hippoBus/pyoro-mms/img/pyoro.png

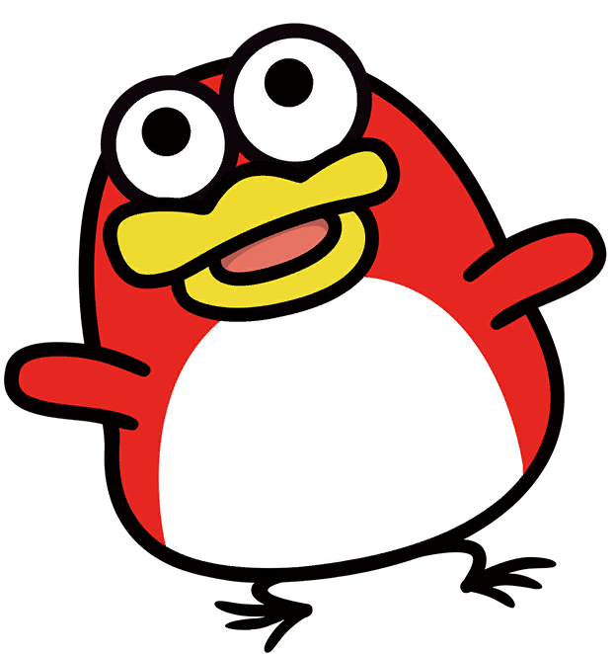
img/pyoro.png
