hippoBus/pyoro-mms/BOM.xlsx

Supplier | Order | Part Number | Count | Quantity | Unit Price | Total Cost | Status | Notes | Link | Datasheet
Digikey | IR. Emitter (940nm) | SFH 4545 | 4 | 10 | 0.529 | 2.116 | Not Ordered |  | https://www.digikey.com/short/p79947wh | https://look.ams-osram.com/m/3456970c8eccd2cb/original/SFH-4545.pdf
 | IR Reciever | TEFT4300 | 4 | 10 | 0.467 | 1.868 | Not Ordered |  | https://www.digikey.com/short/tznrt051 | https://www.vishay.com/docs/81549/teft4300.pdf
 | NMOS | PJA3428_R1_00001 | 5 | 1 | 0.467 | 2.335 | Not Ordered |  | https://www.digikey.com/short/jj7zfb9v | https://toshiba.semicon-storage.com/info/SSM3K335R_datasheet_en_20250321.pdf?did=13020&prodName=SSM3K335R
 | 6-pin JST Header | BM06B-SRSS-TB | 5 | 1 | $0.67 | 3.35 | Not Ordered |  | https://www.digikey.com/short/7rzcn2wm | https://www.jst-mfg.com/product/pdf/eng/eSH.pdf
 | STM32H5 (48 pin) | STM32H503CBT7 | 3 | 1 | 3.54 | 10.62 | Not Ordered | 19 stock remaining | https://www.digikey.com/short/ddcf4p0p | https://www.st.com/resource/en/datasheet/stm32h503eb.pdf
 | Neopixel (10 pack) | 1655 | 1 | 1 | 4.5 | 4.5 | Not Ordered | Package has 10 LEDs | https://www.digikey.com/short/bnrh49nr | https://mm.digikey.com/Volume0/opasdata/d220001/medias/docus/6130/1655.pdf
 | 9-Axis IMU | ICM-20948 | 2 | 1 | 6.78 | 13.56 | Not Ordered |  | https://www.digikey.com/short/0j78n5mz | https://invensense.tdk.com/wp-content/uploads/2024/03/DS-000189-ICM-20948-v1.6.pdf
 | Power Switch | SLW-105558-2A-N-D | 2 | 1 | 0.39 | 0.78 | Not Ordered |  | https://www.digikey.com/short/3vjdjwpw | https://www.sameskydevices.com/product/resource/slw-105558-2a-n-d.pdf
 | Push Button |  | 2 | 1
 | Buzzer | PT-1306T | 1 | 1 | 0.61 | 0.61 | Not Ordered |  | https://www.digikey.com/short/r792247f | https://www.soberton.com/wp-content/uploads/2022/03/PT-1306T.pdf
 | Gate Driver | UCC27524DSDR | 2 | 1 | 1.94 | 3.88 | Not Ordered |  | https://www.digikey.com/short/rztp78f9 | https://www.ti.com/general/docs/suppproductinfo.tsp?distId=10
 | MOSFET H-Bridge | ZXMHC3F381N8TC | 2 | 1 | 1.62 | 3.24 | Not Ordered |  | https://www.digikey.com/short/t558799t | https://www.diodes.com/assets/Datasheets/ZXMHC3F381N8.pdf
 | Yellow LED | B1501UY--20D001913U1930 | 10 | 10 | 0.057 | 0.57 | Not Ordered |  | https://www.digikey.com/short/t550nvpn | https://mm.digikey.com/Volume0/opasdata/d220001/medias/docus/544/B1501UY--20D001913U1930.pdf
 | 1V8 LDO Regulator | MC78LC18NTRG | 1 | 1 | 0.22 | 0.22 | Not Ordered |  | https://www.digikey.com/short/3zfbp3h8 | https://www.onsemi.com/pdf/datasheet/mc78lc00-d.pdf
 | 3V3 LDO Regulator | AP2210N-3.3TRG1 | 1 | 1 | 0.2 | 0.2 | Not Ordered |  | https://www.digikey.com/short/5wrhmztf | https://www.diodes.com/assets/Datasheets/AP2210.pdf
 | 5V LDO Regulator | LM1085ISX-5.0/NOPB | 1 | 1 | 1.84 | 1.84 | Not Ordered |  | https://www.digikey.com/short/f0f7whp5 | https://www.ti.com/lit/ds/symlink/lm1085.pdf
 | 0.1uF Ceramic Cap | C1206C104K5RAC7210 | 13 | 10 | 0.061 | 0.793 | Not Ordered |  | https://www.digikey.com/short/bq453dtn | https://www.yageogroup.com/content/datasheet/asset/file/KEM_C1002_X7R_SMD
 | 1uF Ceramic Cap | CL31B105KAHNNNE | 7 | 1 | 0.12 | 0.84 | Not Ordered |  | https://www.digikey.com/short/7zt9p85r | https://weblib.samsungsem.com/mlcc/mlcc-ec-data-sheet.do?partNumber=CL05Y105KP6VPN
 | 2.2uF Ceramic Cap | CL10A225KO8NNNC | 3 | 1 | 0.08 | 0.24 | Not Ordered |  | https://www.digikey.com/short/f93t7b49 | https://mm.digikey.com/Volume0/opasdata/d220001/medias/docus/421/CL10A225KO8NNNC_Spec.pdf
 | 10uF Tantalum Cap | TAJA106K010SNJ | 2 | 1 | 0.33 | 0.66 | Not Ordered |  | https://www.digikey.com/short/rmr598h3 | https://datasheets.kyocera-avx.com/TAJ.pdf
 | 4.7uF Ceramic Cap | GRM188R61E475KE11D | 3 | 1 | 0.08 | 0.24 | Not Ordered |  | https://www.digikey.com/short/bqb93zpw | https://search.murata.co.jp/Ceramy/image/img/A01X/G101/ENG/GRM188R61E475KE11-01.pdf
 | 100uF Ceramic Cap | 25YXJ100MT15X11 | 4 | 1 | 0.23 | 0.92 | Not Ordered |  | https://www.digikey.com/short/m4nh0t4v | https://www.rubycon.co.jp/wp-content/uploads/catalog-aluminum/YXJ.pdf
 | 33Ω Resistor | ERJ-6GEYJ330V | 1 | 1 | 0.1 | 0.1 | Not Ordered |  | https://www.digikey.com/short/cvdz3p45 | https://industrial.panasonic.com/cdbs/www-data/pdf/RDA0000/AOA0000C301.pdf
 | 220Ω Resistor | RC0402FR-07220RL | 18 | 10 | 0.007 | 0.126 | Not Ordered |  | https://www.digikey.com/short/52hjjmzj | https://www.yageo.com/upload/media/product/products/datasheet/rchip/PYu-RC_Group_51_RoHS_L_12.pdf
 | 500Ω Resistor | RT0603BRC07500RL | 1 | 1 | 0.45 | 0.45 | Not Ordered |  | https://www.digikey.com/short/vdddtf3m | https://www.yageogroup.com/content/datasheet/asset/file/PYU-RT_1-TO-0-01_ROHS_L
 | 1kΩ Resistor | RC0603FR-071KL | 6 | 1 | 0.1 | 0.6 | Not Ordered |  | https://www.digikey.com/short/tjnqbzwq | https://www.yageogroup.com/content/datasheet/asset/file/PYU-RC_GROUP_51_ROHS_L
 | 10kΩ Resistor | RMCF1206FT10K0 | 1 | 1 | 0.1 | 0.1 | Not Ordered |  | https://www.digikey.com/short/d0r20hpq | https://www.seielect.com/catalog/SEI-RMCF_RMCP.pdf
 | 1mH Inductor | LB2518T102K | 1 | 1 | 0.1 | 0.1 | Not Ordered |  | https://www.digikey.com/short/5h5nmp1c | https://mm.digikey.com/Volume0/opasdata/d220001/medias/docus/610/LB2518T102K_SS.pdf
 | Shipping |  |  |  |  | 100
Pololu | Motor Encoder | 4761 | 0 | 1 | 8.95 | 0 | Arrived |  | https://www.pololu.com/product/4761 | https://www.ti.com/lit/ds/symlink/drv5013.pdf | https://www.pololu.com/file/0J1718/pololu-4760-4761-schematic.pdf | https://www.pololu.com/file/0J1721/pololu-4760-4761-dimensions.pdf
 | 50:1 HP 6V Motor | 2213 | 0 | 1 | 24.95 | 0 | Arrived |  | https://www.pololu.com/product/2213/resources | https://www.pololu.com/file/0J1487/pololu-micro-metal-gearmotors-rev-6-1.pdf
 | Wheels | 1087 | 0 | 1 | 4.45 | 0 | Arrived |  | https://www.pololu.com/product/1087/resources | https://www.pololu.com/file/0J1708/pololu-wheel-dimensions.pdf
 | 6-Pin JST Wires | 4765 | 0 | 1 | 3.32 | 0 | Arrived |  | https://www.pololu.com/product/4765
 | Motor Bracket | 989 | 0 | 1 | 2.95 | 0 | Arrived |  | https://www.pololu.com/product/989
Amazon | Motor Driver (10 pack) | L293D | 0 |  | 8.49 | 0 | Arrived | Reused motor driver, | https://www.amazon.com/Bridgold-16-pin-Stepper-Drivers-Controllers/dp/B07NXTWJV9 | https://www.digikey.com/short/npc9rw4r (https://www.digikey.com/en/products/detail/stmicroelectronics/L293D/634700?gad_source=1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)
 | Male Header (Dupont)
 | Female Header (Dupont)
 |  |  |  |  |  | TOTAL COST
 |  |  |  |  |  | 154.858
