hippoBus/pyoro-mms/kicad/componentLib/1655/1655.step

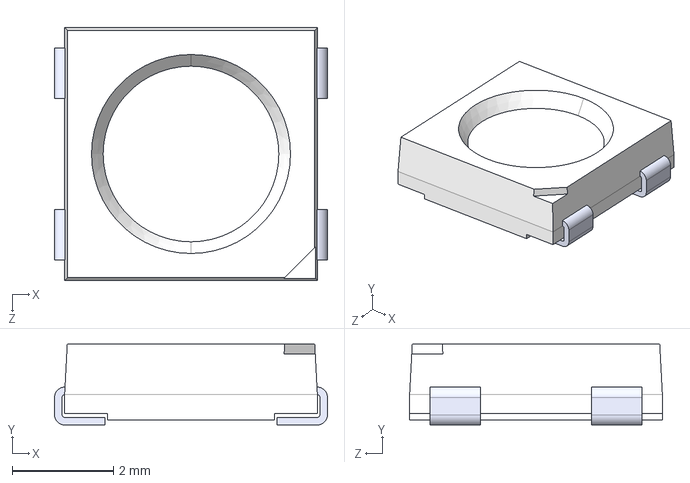
[picture p2: CAD file, 2025-07-08]
kicad/componentLib/1655/1655.step
5.40 x 1.60 x 5.00 mm
