hippoBus/pyoro-mms/kicad/componentLib/AP2210N_3_3TRG1/SOT_3_3TRG1_DIO.step

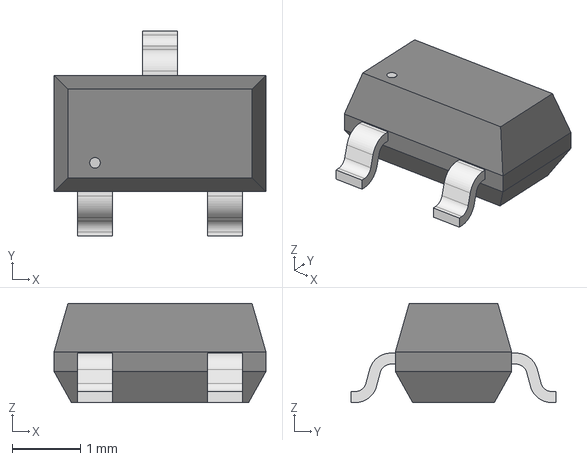
[picture p3: CAD file, 2025-08-04]
kicad/componentLib/AP2210N_3_3TRG1/SOT_3_3TRG1_DIO.step
3.10 x 3.00 x 1.45 mm
