hippoBus/pyoro-mms/kicad/componentLib/BM06B_SRSS_TB_LF__SN_/BM06B-SRSS-TB.STEP

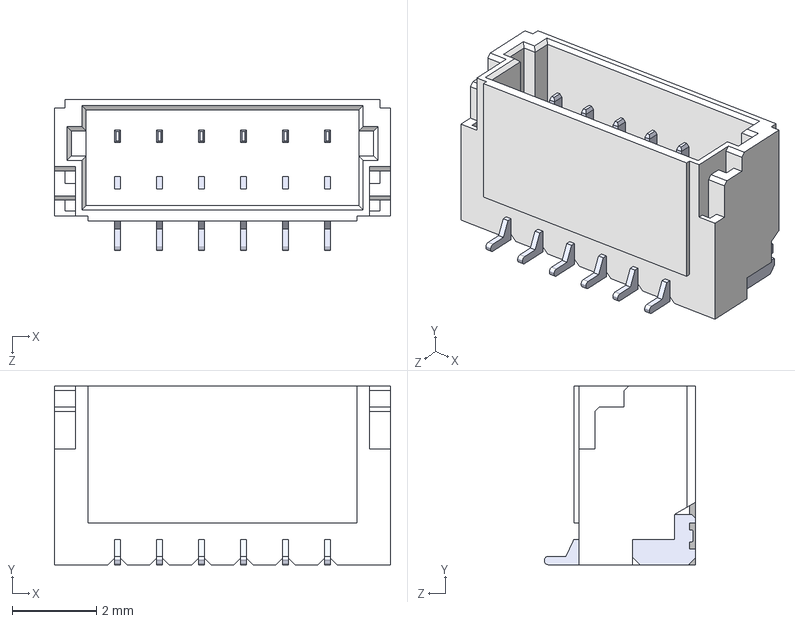
[picture p4: CAD file, 2025-07-08]
kicad/componentLib/BM06B_SRSS_TB_LF__SN_/BM06B-SRSS-TB.STEP
8.00 x 4.25 x 3.60 mm
