hippoBus/pyoro-mms/kicad/componentLib/Cutout.dxf

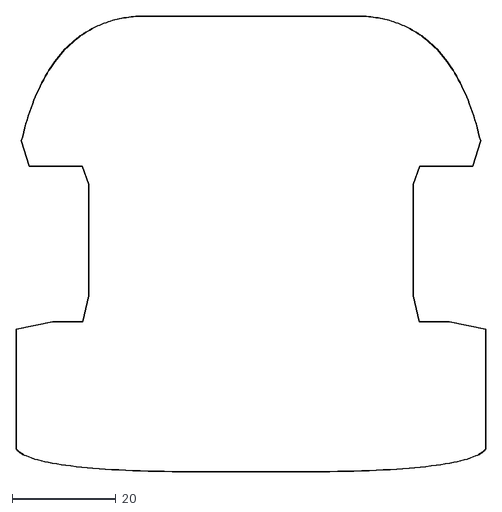
[picture p5: CAD file, 2025-12-12]
kicad/componentLib/Cutout.dxf
90.6 x 88.0
