hippoBus/pyoro-mms/kicad/componentLib/SFH_4545/SFH_4545.step

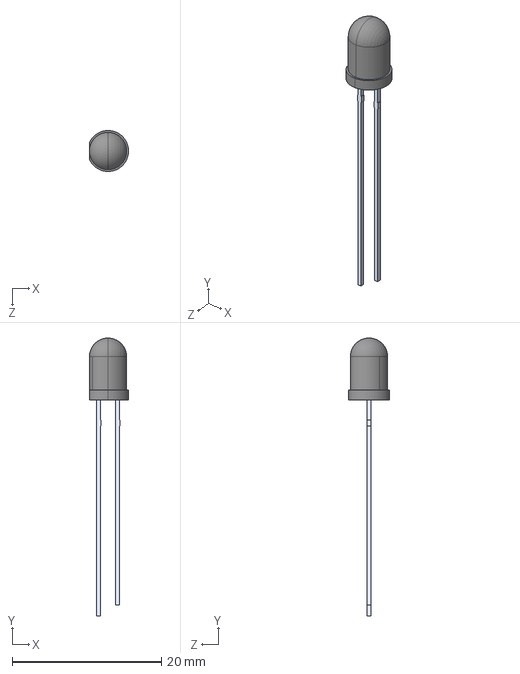
[picture p6: CAD file, 2025-07-08]
kicad/componentLib/SFH_4545/SFH_4545.step
5.25 x 37.3 x 5.50 mm
