hippoBus/pyoro-mms/kicad/componentLib/SLW_105558_2A_N_D/Same_Sky_SLW-105558-2A-N-D.step

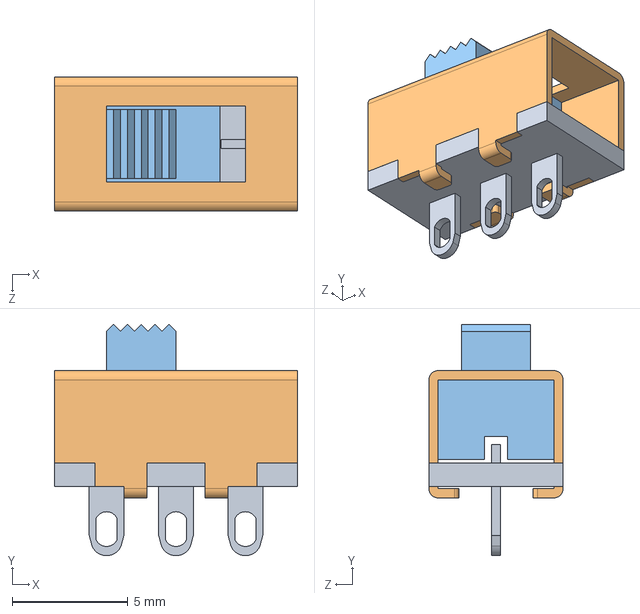
[picture p7: CAD file, 2025-07-08]
kicad/componentLib/SLW_105558_2A_N_D/Same_Sky_SLW-105558-2A-N-D.step
10.5 x 10.00 x 5.80 mm
