hippoBus/pyoro-mms/kicad/componentLib/TEFT4300/TEFT4300.step

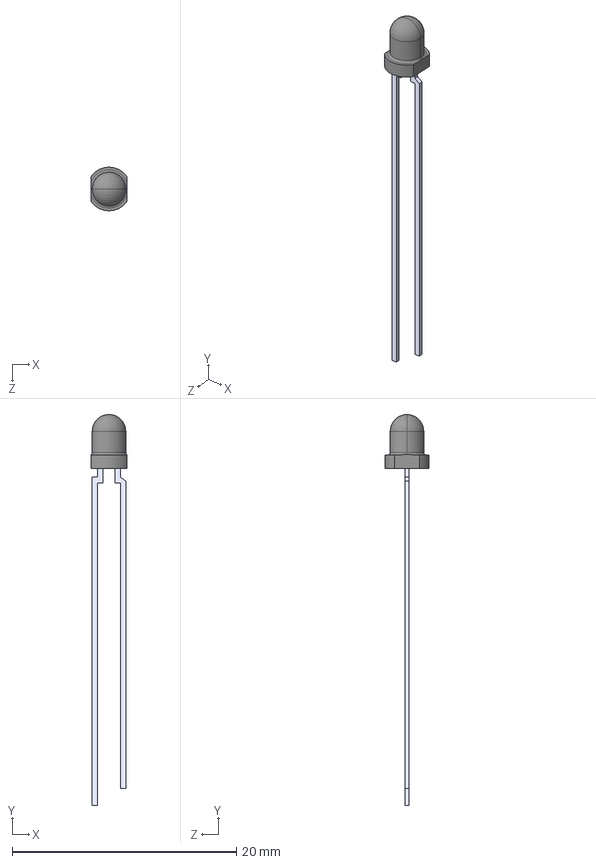
[picture p8: CAD file, 2025-07-08]
kicad/componentLib/TEFT4300/TEFT4300.step
3.20 x 34.9 x 3.90 mm
