hippoBus/pyoro-mms/kicad/componentLib/ZXMHC3F381N8TC/SOIC_81N8TC_DIO.step

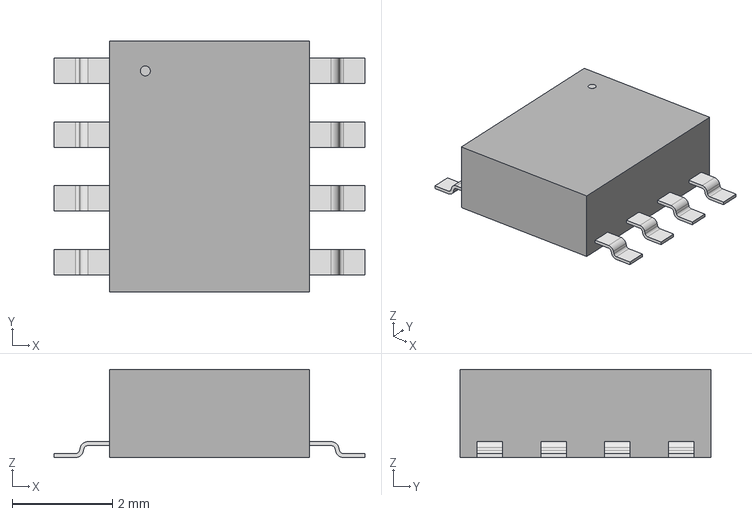
[picture p9: CAD file, 2025-11-27]
kicad/componentLib/ZXMHC3F381N8TC/SOIC_81N8TC_DIO.step
6.20 x 5.00 x 1.75 mm
