hippoBus/pyoro-mms/kicad/PYORO.kicad_pcb

## KiCad design kicad/PYORO.kicad_pcb (2025-12-18)

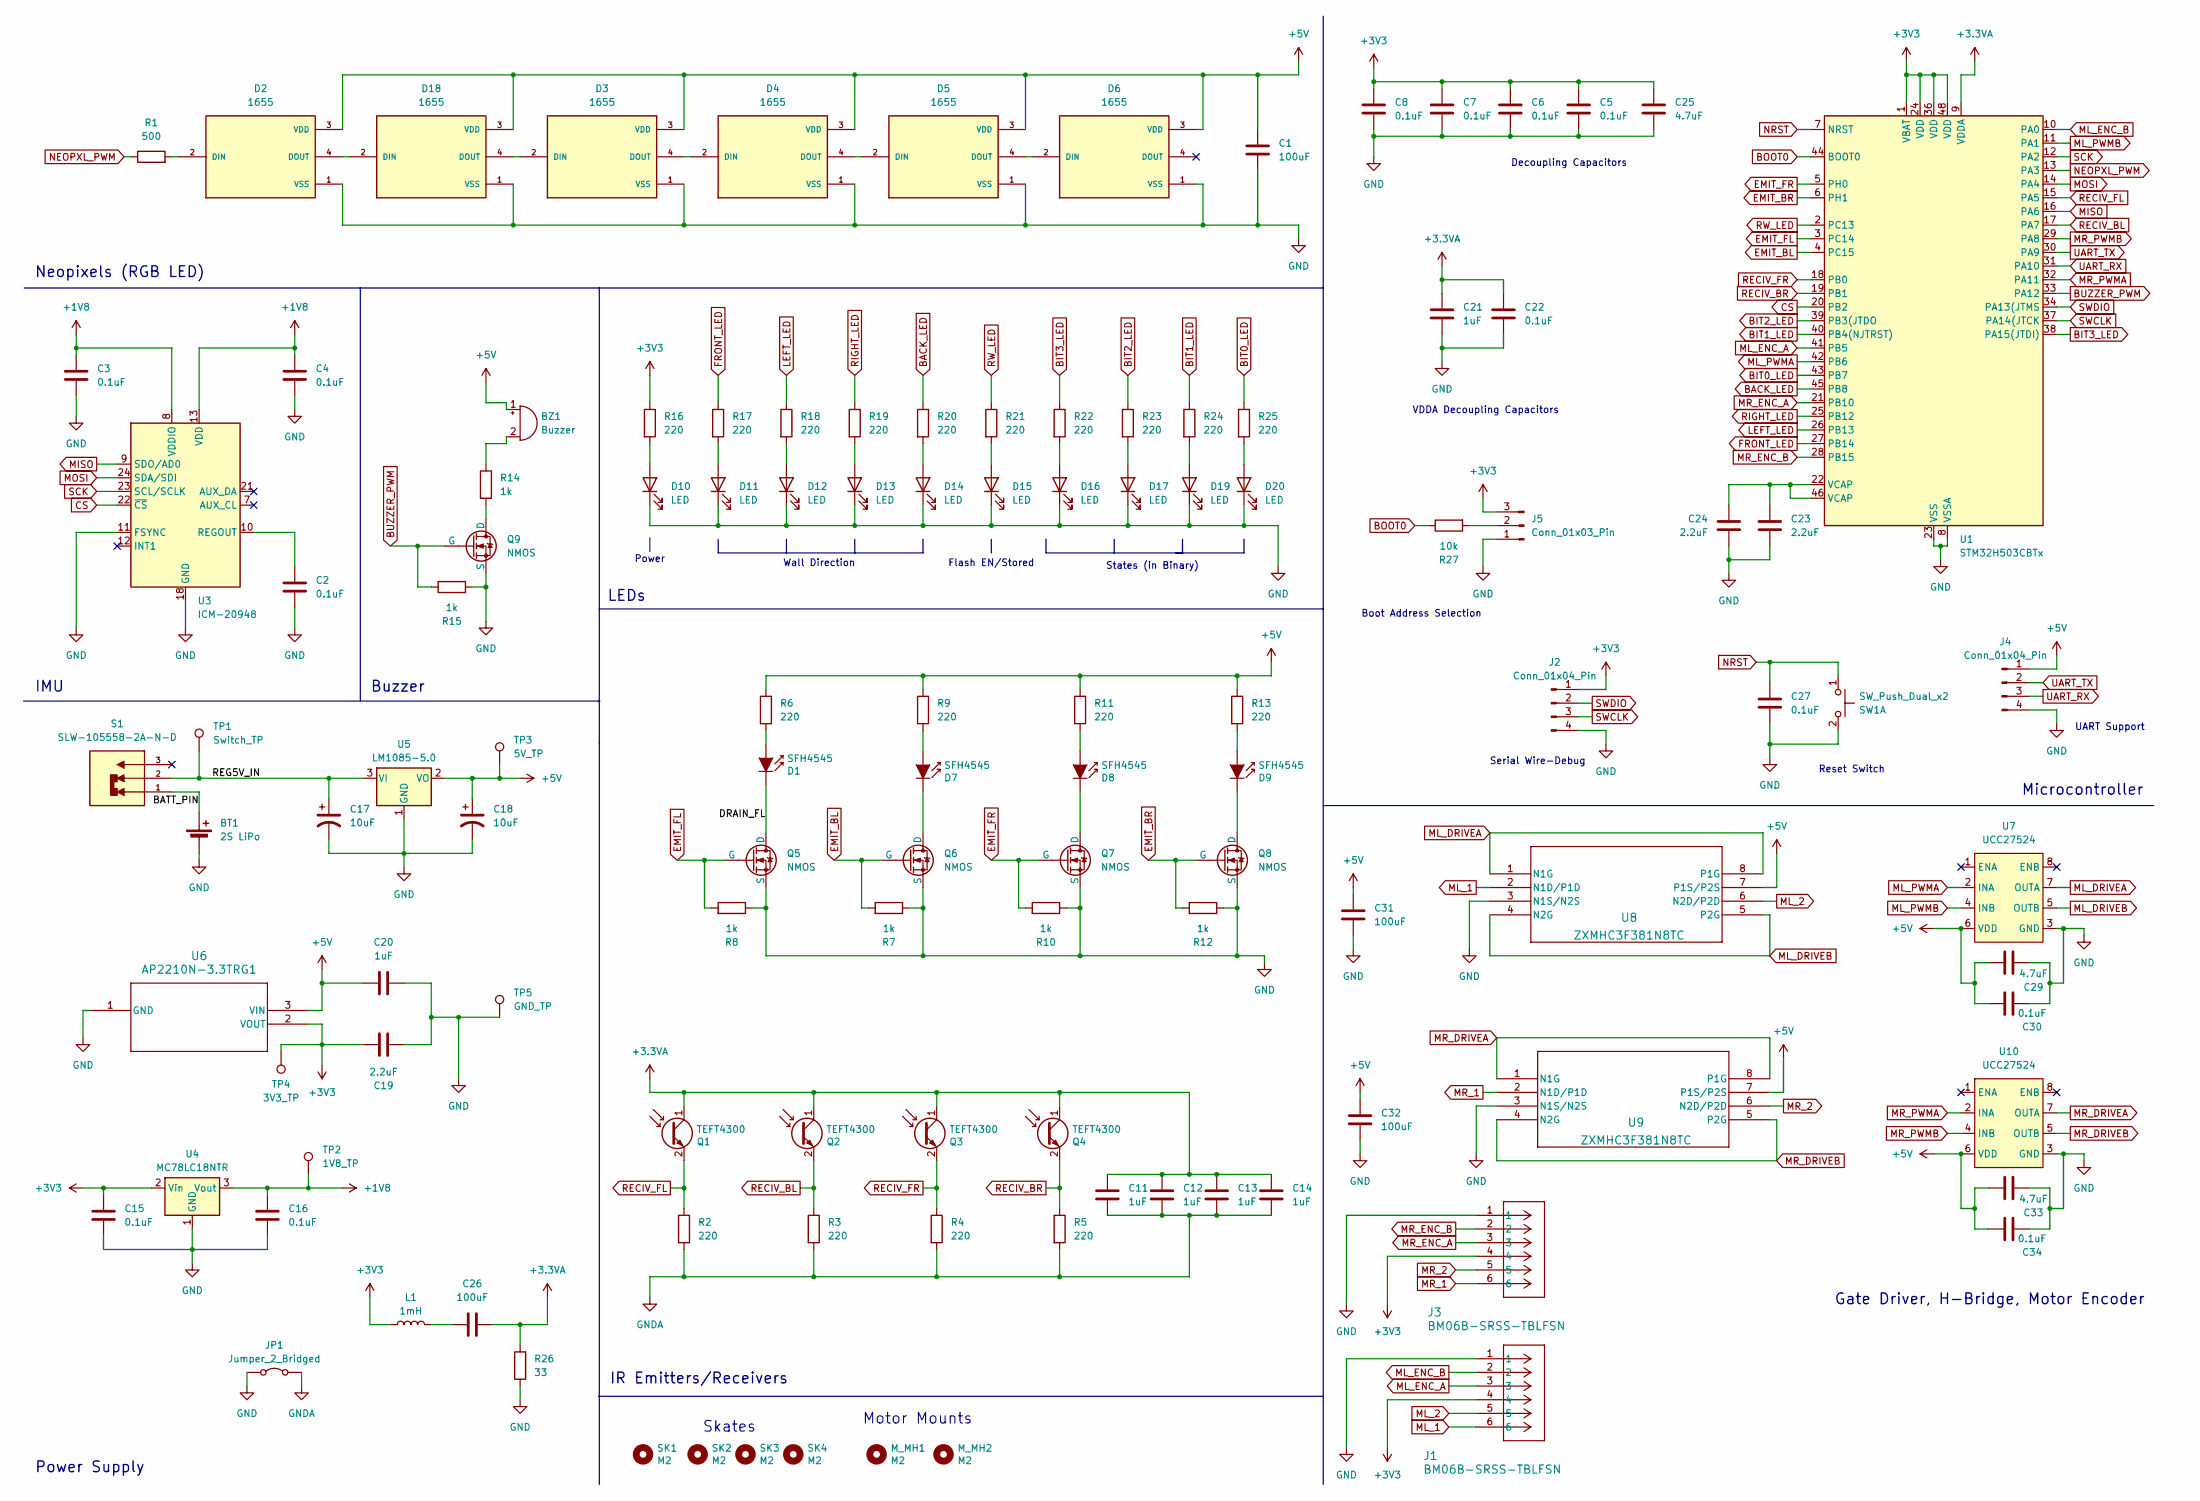
[picture p10: schematic PYORO.kicad_sch, Pyoro Schematic]

Parts:
BT1: 2S LiPo; PinHeader_1x02_P1.00mm_Vertical
BZ1: Buzzer; Buzzer_12x9.5RM7.6
C1, C26, C31, C32: 100uF; CP_Radial_D5.0mm_P2.00mm
C2, C3, C4, C5, C6, C7, C8, C15, C16, C22, C27, C30, C34: 0.1uF; C_1206_3216Metric_Pad1.33x1.80mm_HandSolder
C11, C12, C13, C14, C20, C21: 1uF; C_1206_3216Metric_Pad1.33x1.80mm_HandSolder
C17, C18: 10uF; CP_EIA-3216-18_Kemet-A_Pad1.58x1.35mm_HandSolder
C19, C23, C24: 2.2uF; C_0603_1608Metric_Pad1.08x0.95mm_HandSolder
C25, C29, C33: 4.7uF; C_0603_1608Metric_Pad1.08x0.95mm_HandSolder
D1, D7, D8, D9: SFH4545; Emitter
D2, D3, D4, D5, D6, D18: 1655; LED_1655; PARTREV 01
D10, D11, D12, D13, D14, D15, D16, D17, D19, D20: LED; LED_1206_3216Metric_Pad1.42x1.75mm_HandSolder
J1, J3: BM06B-SRSS-TBLFSN; CONN_BM06B-SRSS-TB_JST
J2, J4: Conn_01x04_Pin; PinHeader_1x04_P1.00mm_Vertical
J5: Conn_01x03_Pin; PinHeader_1x03_P1.00mm_Vertical
JP1: Jumper_2_Bridged; SolderJumper-2_P1.3mm_Bridged_Pad1.0x1.5mm
L1: 1mH; L_1008_2520Metric_Pad1.43x2.20mm_HandSolder
M_MH1, M_MH2: M2; Motor_mouse
Q1, Q2, Q3, Q4: TEFT4300; Emitter
Q5, Q6, Q7, Q8, Q9: NMOS; SOT-23
R1: 500; R_0603_1608Metric_Pad0.98x0.95mm_HandSolder
R2, R3, R4, R5, R6, R9, R11, R13, R16, R17, R18, R19, R20, R21, R22, R23, R24, R25: 220; R_0603_1608Metric_Pad0.98x0.95mm_HandSolder
R7, R8, R10, R12, R14, R15: 1k; R_0603_1608Metric_Pad0.98x0.95mm_HandSolder
R26: 33; R_0805_2012Metric_Pad1.20x1.40mm_HandSolder
R27: 10k; R_1206_3216Metric_Pad1.30x1.75mm_HandSolder
S1: SLW-105558-2A-N-D; SW_SLW-105558-2A-N-D; PARTREV 1.01
SK1, SK2, SK3, SK4: M2; MountingHole_2.2mm_M2
SW1: SW_Push_Dual_x2; SW_SPST_REED_CT05-XXXX-G1
TP1: Switch_TP; PinHeader_1x01_P1.00mm_Vertical
TP2: 1V8_TP; PinHeader_1x01_P1.00mm_Vertical
TP3: 5V_TP; PinHeader_1x01_P1.00mm_Vertical
TP4: 3V3_TP; PinHeader_1x01_P1.00mm_Vertical
TP5: GND_TP; PinHeader_1x01_P1.00mm_Vertical
U1: STM32H503CBTx; LQFP-48_7x7mm_P0.5mm
U3: ICM-20948; InvenSense_QFN-24_3x3mm_P0.4mm
U4: MC78LC18NTR; SOT-23-5
U5: LM1085-5.0; 5V Voltage Reg
U6: AP2210N-3.3TRG1; SOT-23W
U7, U10: UCC27524; DSD8_2P15X1P2
U8, U9: ZXMHC3F381N8TC; SOIC-8_3.9x4.9mm_P1.27mm

Connections:
+1V8: C3.2, C4.2, C16.1, TP2.1, U3.8 (VDDIO), U3.13 (VDD), U4.3 (Vout)
+3.3VA: C11.1, C12.1, C13.1, C14.1, C21.1, C22.1, C26.2, Q1.1 (C), Q2.1 (C), Q3.1 (C), Q4.1 (C), R26.2, U1.9 (VDDA)
+3V3: C5.1, C6.1, C7.1, C8.1, C15.1, C19.2, C25.1, J1.4, J2.1, J3.4, J5.3, L1.1, R16.1, TP4.1, U1.1 (VBAT), U1.24 (VDD), U1.36 (VDD), U1.48 (VDD), U4.2 (Vin), U6.2 (VOUT)
+5V: BZ1.1 (+), C1.1, C18.1, C20.1, C29.2, C30.2, C31.1, C32.1, C33.2, C34.2, D2.3 (VDD), D3.3 (VDD), D4.3 (VDD), D5.3 (VDD), D6.3 (VDD), D18.3 (VDD), J4.1, R6.1, R9.1, R11.1, R13.1, TP3.1, U5.2 (VO), U6.3 (VIN), U7.6 (VDD), U8.7 (P1S/P2S), U9.7 (P1S/P2S), U10.6 (VDD)
/BATT_PIN: BT1.1 (+), S1.1
/DRAIN_FL: D1.1 (K), Q5.1 (D)
/REG5V_IN: C17.1, S1.2, TP1.1, U5.3 (VI)
BACK_LED: R20.1, U1.45 (PB8)
BIT0_LED: R25.1, U1.43 (PB7)
BIT1_LED: R24.1, U1.40 (PB4(NJTRST))
BIT2_LED: R23.1, U1.39 (PB3(JTDO)
BIT3_LED: R22.1, U1.38 (PA15(JTDI))
BOOT0: R27.1, U1.44 (BOOT0)
BUZZER_PWM: Q9.2 (G), R15.1, U1.33 (PA12)
CS: U1.20 (PB2), U3.22 (~CS)
EMIT_BL: Q6.2 (G), R7.2, U1.4 (PC15)
EMIT_BR: Q8.2 (G), R12.2, U1.6 (PH1)
EMIT_FL: Q5.2 (G), R8.2, U1.3 (PC14)
EMIT_FR: Q7.2 (G), R10.2, U1.5 (PH0)
FRONT_LED: R17.1, U1.27 (PB14)
GND: BT1.2 (-), C1.2, C2.2, C3.1, C4.1, C5.2, C6.2, C7.2, C8.2, C15.2, C16.2, C17.2, C18.2, C19.1, C20.2, C21.2, C22.2, C23.2, C24.2, C25.2, C27.2, C29.1, C30.1, C31.2, C32.2, C33.1, C34.1, D2.1 (VSS), D3.1 (VSS), D4.1 (VSS), D5.1 (VSS), D6.1 (VSS), D10.1 (K), D11.1 (K), D12.1 (K), D13.1 (K), D14.1 (K), D15.1 (K), D16.1 (K), D17.1 (K), D18.1 (VSS), D19.1 (K), D20.1 (K), J1.1, J2.4, J3.1, J4.4, J5.1, JP1.1 (A), Q5.3 (S), Q6.3 (S), Q7.3 (S), Q8.3 (S), Q9.3 (S), R7.1, R8.1, R10.1, R12.1, R15.2, R26.1, SW1.2 (D), TP5.1, U1.8 (VSSA), U1.23 (VSS), U1.35 (VSS), U1.47 (VSS), U3.11 (FSYNC), U3.18 (GND), U3.20 (GND), U4.1 (GND), U5.1 (GND), U6.1 (GND), U7.3 (GND), U8.3 (N1S/N2S), U9.3 (N1S/N2S), U10.3 (GND)
GNDA: C11.2, C12.2, C13.2, C14.2, JP1.2 (B), R2.2, R3.2, R4.2, R5.2
LEFT_LED: R18.1, U1.26 (PB13)
MISO: U1.16 (PA6), U3.9 (SDO/AD0)
ML_1: J1.6, U8.2 (N1D/P1D)
ML_2: J1.5, U8.6 (N2D/P2D)
ML_DRIVEA: U7.7 (OUTA), U8.1 (N1G), U8.8 (P1G)
ML_DRIVEB: U7.5 (OUTB), U8.4 (N2G), U8.5 (P2G)
ML_ENC_A: J1.3, U1.41 (PB5)
ML_ENC_B: J1.2, U1.10 (PA0)
ML_PWMA: U1.42 (PB6), U7.2 (INA)
ML_PWMB: U1.11 (PA1), U7.4 (INB)
MOSI: U1.14 (PA4), U3.24 (SDA/SDI)
MR_1: J3.6, U9.2 (N1D/P1D)
MR_2: J3.5, U9.6 (N2D/P2D)
MR_DRIVEA: U9.1 (N1G), U9.8 (P1G), U10.7 (OUTA)
MR_DRIVEB: U9.4 (N2G), U9.5 (P2G), U10.5 (OUTB)
MR_ENC_A: J3.3, U1.21 (PB10)
MR_ENC_B: J3.2, U1.28 (PB15)
MR_PWMA: U1.32 (PA11), U10.2 (INA)
MR_PWMB: U1.29 (PA8), U10.4 (INB)
NEOPXL_PWM: R1.1, U1.13 (PA3)
NRST: C27.1, SW1.1 (C), U1.7 (NRST)
unnamed: BZ1.2 (-), R14.1
unnamed: C23.1, C24.1, U1.22 (VCAP), U1.46 (VCAP)
unnamed: C26.1, L1.2
unnamed: D1.2 (A), R6.2
unnamed: D2.2 (DIN), R1.2
unnamed: D3.4 (DOUT), D4.2 (DIN)
unnamed: D4.4 (DOUT), D5.2 (DIN)
unnamed: D5.4 (DOUT), D6.2 (DIN)
unnamed: D7.2 (A), R9.2
unnamed: D7.1 (K), Q6.1 (D)
unnamed: D8.2 (A), R11.2
unnamed: D8.1 (K), Q7.1 (D)
unnamed: D9.2 (A), R13.2
unnamed: D9.1 (K), Q8.1 (D)
unnamed: D10.2 (A), R16.2
unnamed: D11.2 (A), R17.2
unnamed: D12.2 (A), R18.2
unnamed: D13.2 (A), R19.2
unnamed: D14.2 (A), R20.2
unnamed: D15.2 (A), R21.2
unnamed: D16.2 (A), R22.2
unnamed: D17.2 (A), R23.2
unnamed: D2.4 (DOUT), D18.2 (DIN)
unnamed: D3.2 (DIN), D18.4 (DOUT)
unnamed: D19.2 (A), R24.2
unnamed: D20.2 (A), R25.2
unnamed: J5.2, R27.2
unnamed: Q9.1 (D), R14.2
unnamed: C2.1, U3.10 (REGOUT)
RECIV_BL: Q2.2 (E), R3.1, U1.17 (PA7)
RECIV_BR: Q4.2 (E), R5.1, U1.19 (PB1)
RECIV_FL: Q1.2 (E), R2.1, U1.15 (PA5)
RECIV_FR: Q3.2 (E), R4.1, U1.18 (PB0)
RIGHT_LED: R19.1, U1.25 (PB12)
RW_LED: R21.1, U1.2 (PC13)
SCK: U1.12 (PA2), U3.23 (SCL/SCLK)
SWCLK: J2.3, U1.37 (PA14(JTCK)
SWDIO: J2.2, U1.34 (PA13(JTMS)
UART_RX: J4.3, U1.31 (PA10)
UART_TX: J4.2, U1.30 (PA9)

Notes on the sheet:
Power Supply
Neopixels (RGB LED)
LEDs
States (in Binary)
VDDA Decoupling Capacitors
Wall Direction
UART Support
Flash EN/Stored
Buzzer
Skates
Boot Address Selection
Motor Mounts
Power
IMU
Serial Wire-Debug
Reset Switch
Gate Driver, H-Bridge, Motor Encoder
Decoupling Capacitors
IR Emitters/Receivers
Microcontroller

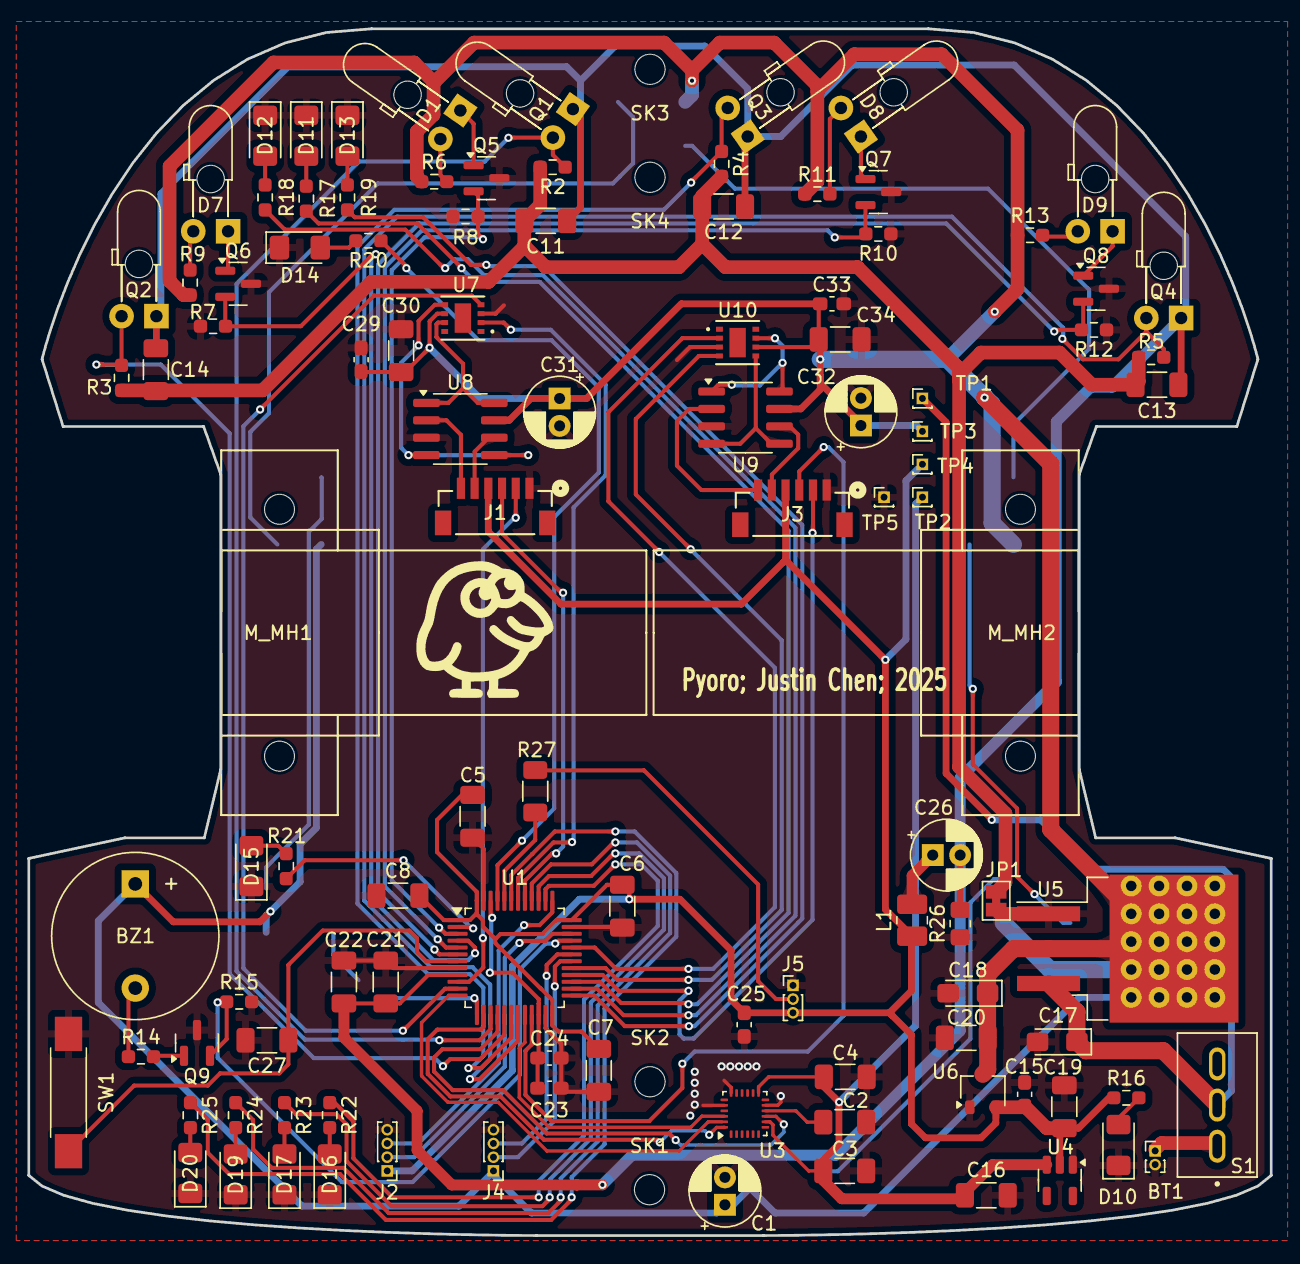
[picture p11: board PYORO.kicad_pcb from above]

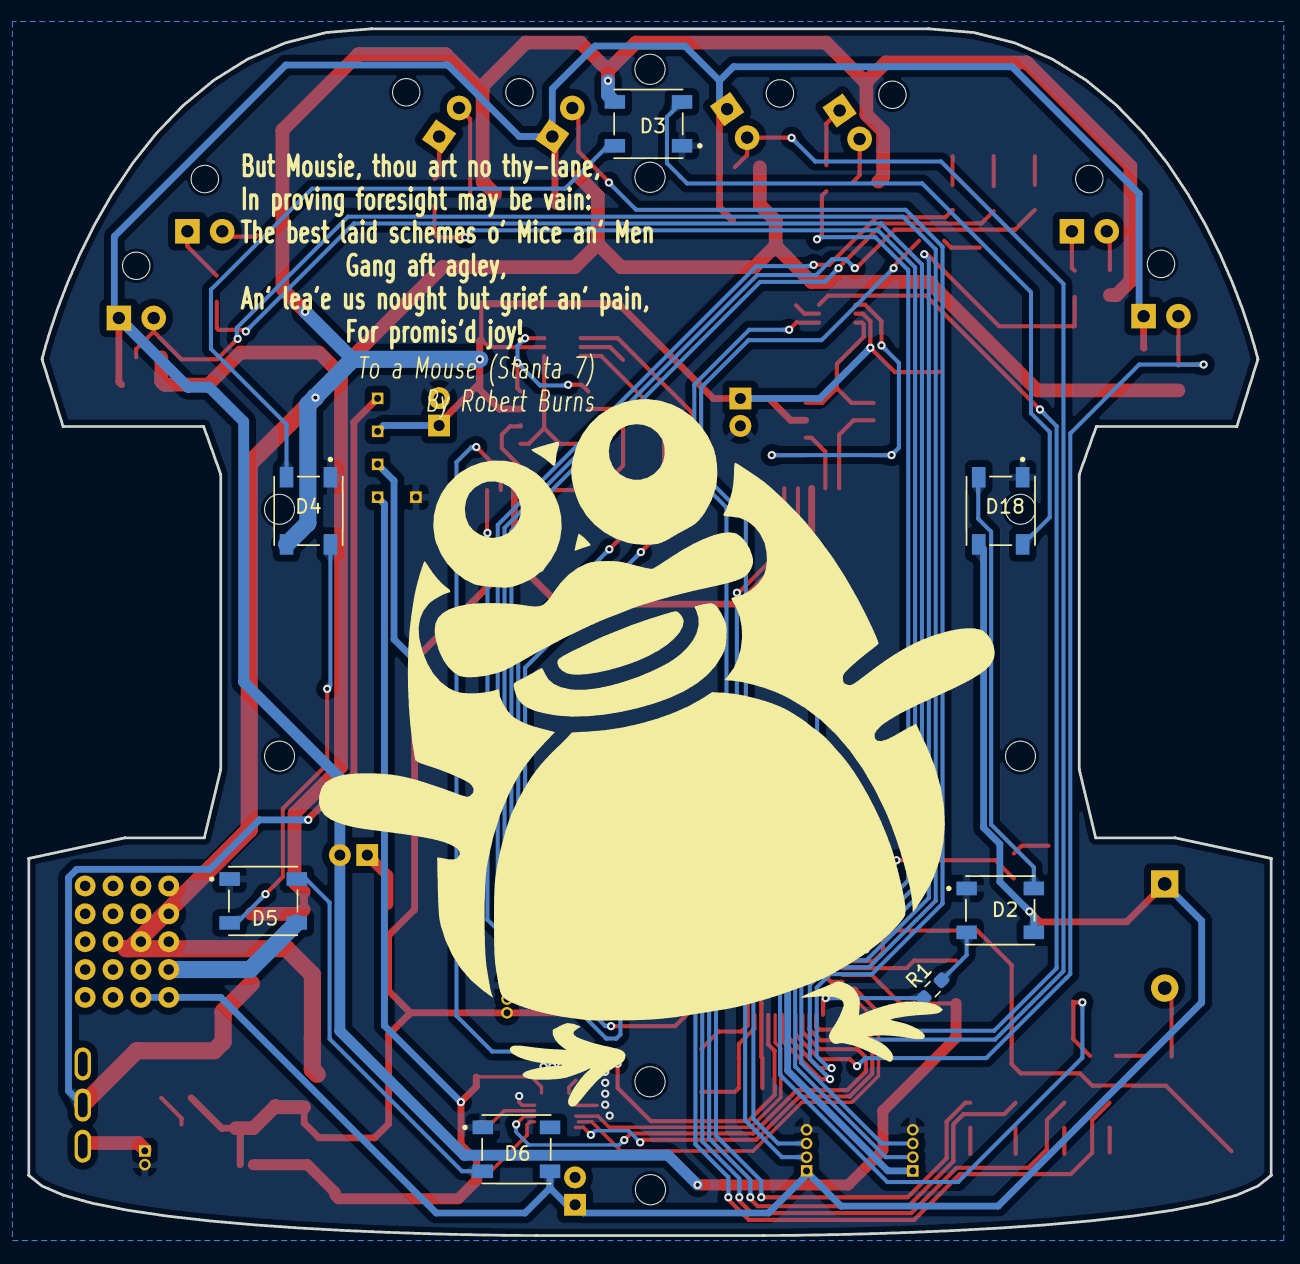
[picture p12: board PYORO.kicad_pcb from below]

Board: 2 copper layers, 90.6 x 88.0 mm, 118 parts (7 on the bottom side), 83 nets.
