hippoBus/pyoro-mms/stm32_code/pyoro.ioc

Mcu.UserName=STM32H503CBTx
PA0.GPIO_Label=ML_ENC_B
PA0.Signal=LPTIM1_IN2
PA1.GPIO_Label=ML_PWMB
PA1.Signal=S_TIM1_CH3
PA10.Signal=USART1_RX
PA11.GPIO_Label=MR_PWMA
PA11.Signal=S_TIM1_CH4
PA12.GPIO_Label=BUZZER_PWM
PA12.Signal=S_TIM3_CH4
PA13(JTMS/SWDIO).GPIO_Label=SWDIO
PA13(JTMS/SWDIO).Signal=DEBUG_JTMS-SWDIO
PA14(JTCK/SWCLK).GPIO_Label=SWCLK
PA14(JTCK/SWCLK).Signal=DEBUG_JTCK-SWCLK
PA15(JTDI).GPIO_Label=BIT3_LED
PA15(JTDI).Signal=GPIO_Output
PA2.Signal=SPI1_SCK
PA3.GPIO_Label=NEOPXL_PWM
PA3.Signal=S_TIM2_CH4
PA4.Signal=SPI1_MOSI
PA5.GPIO_Label=RECIV_FL
PA5.Signal=ADCx_INP19
PA6.Signal=SPI1_MISO
PA7.GPIO_Label=RECIV_BL
PA7.Signal=ADCx_INP7
PA8.GPIO_Label=MR_PWMB
PA8.Signal=S_TIM1_CH1
PA9.Signal=USART1_TX
PB0.GPIO_Label=RECIV_FR
PB0.Signal=ADCx_INP9
PB1.GPIO_Label=RECIV_BR
PB1.Signal=ADCx_INP5
PB10.GPIO_Label=MR_ENC_A
PB10.Signal=LPTIM2_IN1
PB12.GPIO_Label=RIGHT_LED
PB12.Signal=GPIO_Output
PB13.GPIO_Label=LEFT_LED
PB13.Signal=GPIO_Output
PB14.GPIO_Label=FRONT_LED
PB14.Signal=GPIO_Output
PB15.GPIO_Label=MR_ENC_B
PB15.Signal=LPTIM2_IN2
PB2.GPIO_Label=SPI1_CS
PB2.Signal=GPIO_Output
PB3(JTDO/TRACESWO).GPIO_Label=BIT2_LED
PB3(JTDO/TRACESWO).Signal=GPIO_Output
PB4(NJTRST).GPIO_Label=BIT1_LED
PB4(NJTRST).Signal=GPIO_Output
PB5.GPIO_Label=ML_ENC_A
PB5.Signal=LPTIM1_IN1
PB6.GPIO_Label=ML_PWMA
PB6.Signal=S_TIM1_CH2
PB7.GPIO_Label=BIT0_LED
PB7.Signal=GPIO_Output
PB8.GPIO_Label=BACK_LED
PB8.Signal=GPIO_Output
PC13.GPIO_Label=RW_LED
PC13.Signal=GPIO_Output
PC14-OSC32_IN(OSC32_IN).GPIO_Label=EMIT_FL
PC14-OSC32_IN(OSC32_IN).Signal=GPIO_Output
PC15-OSC32_OUT(OSC32_OUT).GPIO_Label=EMIT_BL
PC15-OSC32_OUT(OSC32_OUT).Signal=GPIO_Output
PH0-OSC_IN(PH0).GPIO_Label=EMIT_FR
PH0-OSC_IN(PH0).Signal=GPIO_Output
PH1-OSC_OUT(PH1).GPIO_Label=EMIT_BR
PH1-OSC_OUT(PH1).Signal=GPIO_Output
