hippoBus/pyoro-mms/(commit log)

2025-06-30 Initialize KiCad project
    [PYORO.kicad_pcb, PYORO.kicad_sch]
2025-07-08 Imported majority of compoents in KiCad
    [1655.step, BM06B-SRSS-TB.STEP, PYORO.kicad_sch, SFH_4545.step, Same_Sky_SLW-105558-2A-N-D.step, TEFT4300.step]
2025-07-14 Setup stm32CubeIDE project
2025-07-14 Started IMU circuit
    [PYORO.kicad_sch]
2025-07-21 Started motor controller
    [PYORO.kicad_sch]
2025-07-22 Started 6-pin JST Headers
    [PYORO.kicad_sch]
2025-07-23 Started IR Receivers, and changed pin assignment
    [PYORO.kicad_sch]
2025-07-31 Started IR Emitters, and enable MCU flash
    [PYORO.kicad_sch]
2025-08-02 Started Buzzer
    [PYORO.kicad_sch]
2025-08-04 Started voltage regulators
    [PYORO.kicad_sch, SOT_3_3TRG1_DIO.step]
2025-08-05 Added Neopixel PWM pin, and reoganized schematic
    [PYORO.kicad_sch]
2025-08-05 Started LEDs for the extra GPIO pins
    [PYORO.kicad_sch]
2025-08-07 Added new test points, updated missing Capacitor and Resistor values, fix MCU power supply scheme
    [PYORO.kicad_sch]
2025-08-08 Added Filtering for 3.3VA
    [PYORO.kicad_sch]
2025-08-18 Fixed spelling errors
    [PYORO.kicad_sch]
2025-08-18 Converted capacitor units
    [PYORO.kicad_sch]
2025-09-21 Added new symbols for silkscreen and IMU backup
    [PYORO.kicad_sch]
2025-09-21 Fix some schematics error, and define resistor values
    [PYORO.kicad_sch]
2025-11-12 Added UART support incase
    [PYORO.csv, PYORO.kicad_sch]
2025-11-13 Add the remaining stm32 drivers incase
2025-11-27 Modified LEDs, started Gate Driver, change H-Bridge
    [PYORO.kicad_sch, SOIC_81N8TC_DIO.step]
2025-11-28 Removed Enable pins for H-Bridge
    [PYORO.kicad_sch]
2025-11-29 Added 2 PWM channels for motors, and moved from UART3 to UART1
    [PYORO.kicad_sch]
2025-11-29 Moved Motor PWM gen. to TIM1, and moved pin assignments
    [PYORO.kicad_sch]
2025-11-29 Completed pin assignments
    [PYORO.kicad_sch]
2025-11-30 Added BOM, and finalized RLC Bandpass filter
    [BOM.xlsx, PYORO.kicad_sch]
2025-11-30 Moved all 4 PWM Generations to seperate channels
    [PYORO.kicad_sch]
2025-12-10 Finish importing BOM parts and footprint assignment
    [DSD0008D.stp, PYORO.kicad_sch]
2025-12-11 Added skate holes and motor mount holes
    [PYORO.kicad_sch]
2025-12-12 Setup edgecuts, and Board Setup
    [Cutout.dxf, PYORO.kicad_pcb, PYORO.kicad_sch]
2025-12-12 Started Pwr Supply layout
    [PYORO.kicad_pcb, PYORO.kicad_sch]
2025-12-12 Changed graphic fonts
    [PYORO.kicad_pcb]
2025-12-13 Added IMU to layout
2025-12-13 Added motor drivers to layout
2025-12-13 Added IR layout, and modified symbols for IR
    [PYORO.kicad_sch]
2025-12-15 Added stm32 to layout
    [PYORO.kicad_sch]
2025-12-16 Add wall direction LEDs to layout
    [PYORO.kicad_sch]
2025-12-17 Added binary state LEDs
2025-12-17 Finalized silkscreen, and fix remaining DRC
2025-12-17 Removed extra footprints, fixed silkscreen
2025-12-18 Fixed fonts that did not match the rest
    [PYORO.kicad_pcb]
